jsdriskill/K6TTA-keyer/hardware/README.md

# K6TTA keyer hardware v0.1

Two KiCad 10 projects. Both boards are routed with GND pours on both layers and pass DRC
(only cosmetic silkscreen and library-version warnings remain).

* `k6tta-main/` main board, 64 x 56 mm: RP2040-Zero on sockets (USB-C to the rear), rig jack at the rear facing back,
  paddle jack front-right, headphone jack left with the thumbwheel in front of it, 2x8 right-angle socket on the front edge.
* `k6tta-front/` front board, 76 x 54 mm: 0.96in SSD1306 OLED (on a 1x4 socket), EC11 encoder, three 12 mm message buttons,
  2x8 straight header soldered on the BACK so it plugs into the main board's right-angle socket.

Pin assignments come from `config.h` (GP2 dit, GP3 dah, GP4 TX key, GP5 sidetone, GP6-8 encoder,
GP9-11 message buttons, GP12/13 I2C).

The KiCad files are the source of truth. The scripts in `generator/` produced the first unrouted draft and the
netlist/BOM CSVs; part positions in them no longer match the routed boards.

## Checked

* **RP2040-Zero pinout** (`K6TTA:RP2040-Zero_Socketed`): pad 1 = 5V top-left with USB-C up, GP0 top-right,
  GP9..GP13 on the short row opposite the USB (GP13 at the left). Confirmed against the clone in use.
* **Thumbwheel RV1** (Alps RK10J11E0034, `K6TTA:Alps_RK10J_Thumbwheel_5pin`): footprint checked against the Alps
  PC board drawing. It is a single pot: pads 1, 3, 5 = datasheet pins 1 (end), 2 (wiper), 3 (end); pads 2 and 4
  are dummy terminals. Wired as a rheostat: VOL_IN to pad 1, wiper (pad 3) tied to pad 5 and the headphones.

## Still to check

* **Board-to-board header**: main J5 odd pins (rear row of the right-angle socket, upper opening) carry the signals;
  front J1 even pins (upper row) mate with them. Check the height of the socket openings against where the front board sits.
* **OLED module**: pin order GND VCC SCL SDA; it is held only by its socket, so support it with standoffs or the panel.
* **LCSC numbers**: all JLCPCB-placed parts are chosen from the Basic library (the "JLC class" column says which were
  confirmed); re-check stock when you order.

R8 (speaker series resistor) is a 1/2 W axial part you solder, so you can change the speaker level.
