jsdriskill/K6TTA-keyer/hardware/k6tta-main/k6tta-main-netlist.csv

Net | Pins
+3V3 | C8.1 J5.4 R1.2 R2.2 U1.3
+5V | C5.1 C6.1 C7.1 R8.1 U1.1
DAH | C2.1 J1.R R2.1 U1.20
DIT | C1.1 J1.T R1.1 U1.21
ENC_A | J5.15 U1.17
ENC_B | J5.13 U1.16
ENC_SW | J5.11 U1.15
GATE | Q1.1 R6.2 R7.1
GND | C1.2 C2.2 C3.2 C5.2 C6.2 C7.2 C8.2 J1.S J3.S J5.2 J5.6 J5.8 J5.10 J5.12 J5.14 J5.16 Q1.2 R7.2 U1.2 U2.2
HP | J3.R J3.T RV1.3 RV1.5
HP_SW | J3.TN R6.1
LED_A | R3.2 U2.1
MSG1 | J5.9 U1.14
MSG2 | J5.7 U1.13
MSG3 | J5.5 U1.12
OPTO_B | R4.1 U2.6
RIG_COM | C3.1 C4.2 J2.S R4.2 U2.4
RIG_KEY | C4.1 J2.T U2.5
SCL | J5.1 U1.10
SDA | J5.3 U1.11
SIDETONE | R5.1 U1.18
SPK_N | D1.2 J4.2 Q1.3
SPK_P | D1.1 J4.1 R8.2
TX_KEY | R3.1 U1.19
VOL_IN | R5.2 RV1.1
