jsdriskill/K6TTA-keyer/hardware/k6tta-front/k6tta-front-netlist.csv

Net | Pins
+3V3 | J1.3 J2.2
ENC_A | J1.16 SW1.A
ENC_B | J1.14 SW1.B
ENC_SW | J1.12 SW1.S1
GND | J1.1 J1.5 J1.7 J1.9 J1.11 J1.13 J1.15 J2.1 SW1.C SW1.S2 SW2.2 SW3.2 SW4.2
MSG1 | J1.10 SW2.1
MSG2 | J1.8 SW3.1
MSG3 | J1.6 SW4.1
SCL | J1.2 J2.3
SDA | J1.4 J2.4
