jsdriskill/K6TTA-keyer/hardware/previews/k6tta-front-preview.png

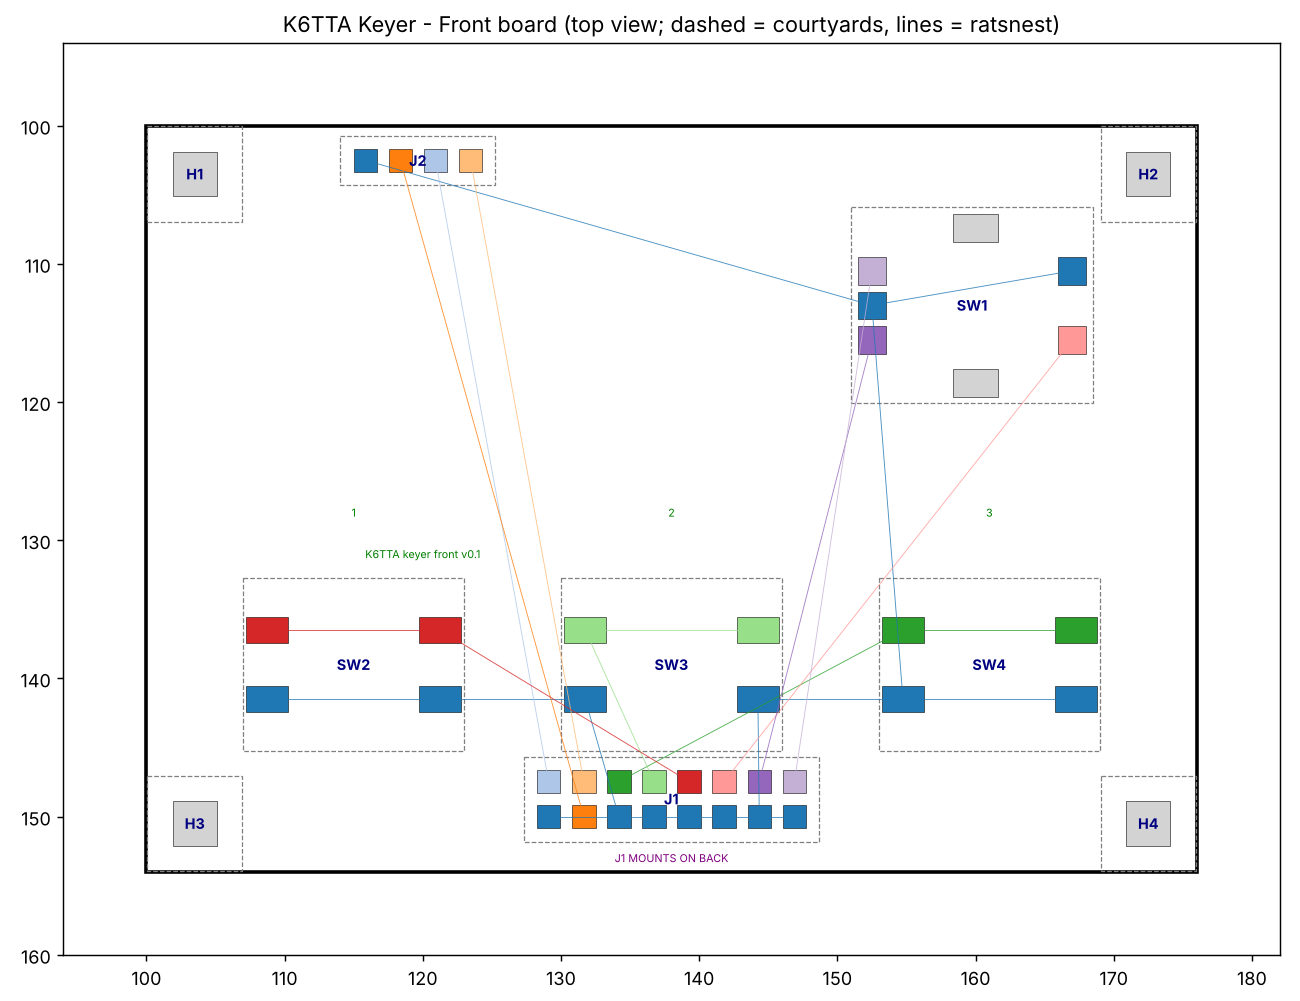
hardware/previews/k6tta-front-preview.png
