jsdriskill/K6TTA-keyer/hardware/previews/k6tta-main-preview.png

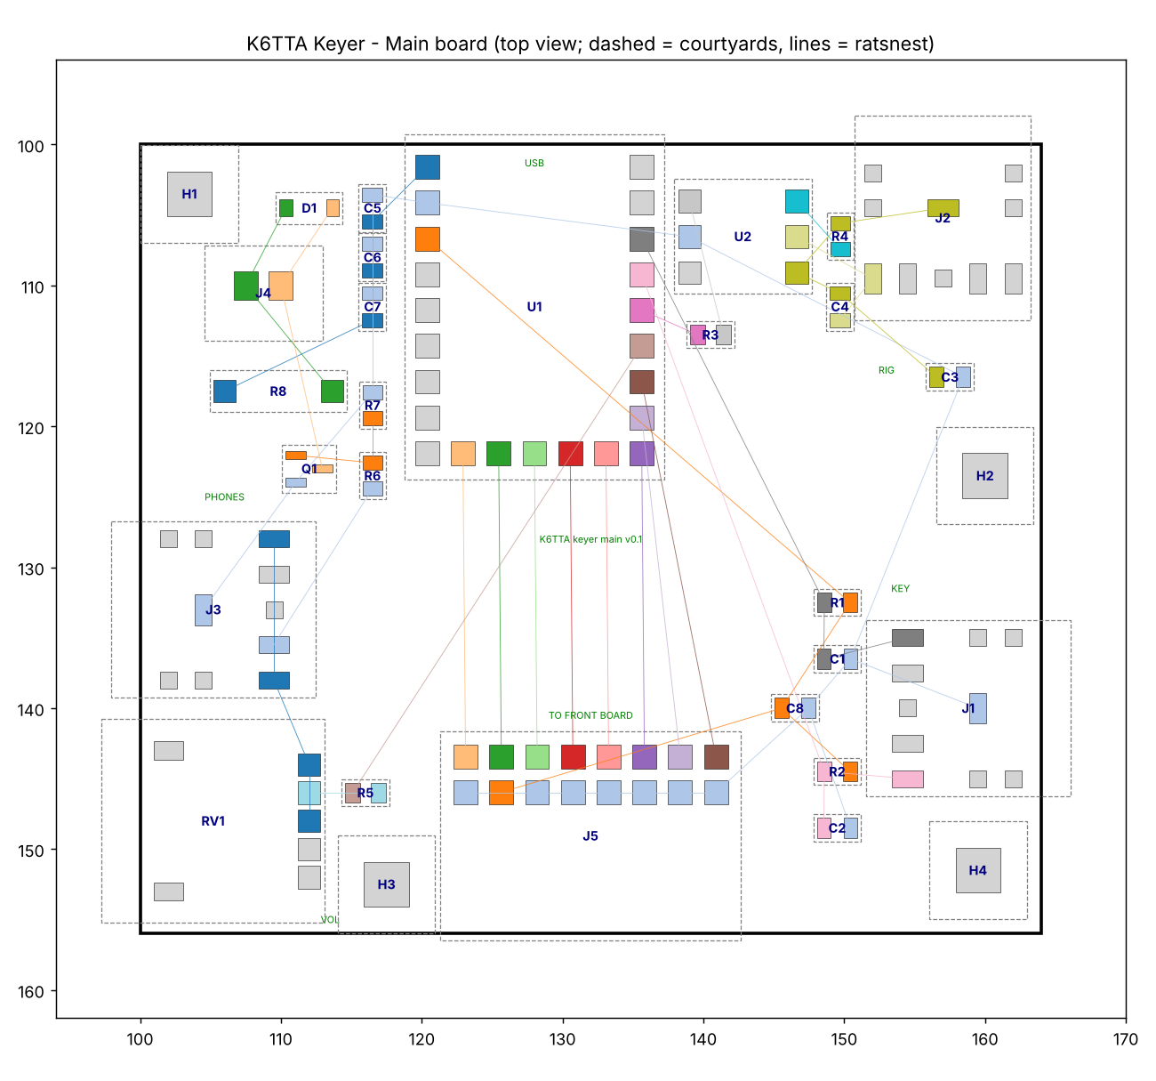
hardware/previews/k6tta-main-preview.png
