jsdriskill/K6TTA-keyer/hardware/k6tta-main/k6tta-main.kicad_pcb

## KiCad design hardware/k6tta-main/k6tta-main.kicad_pcb (2026-11-14)

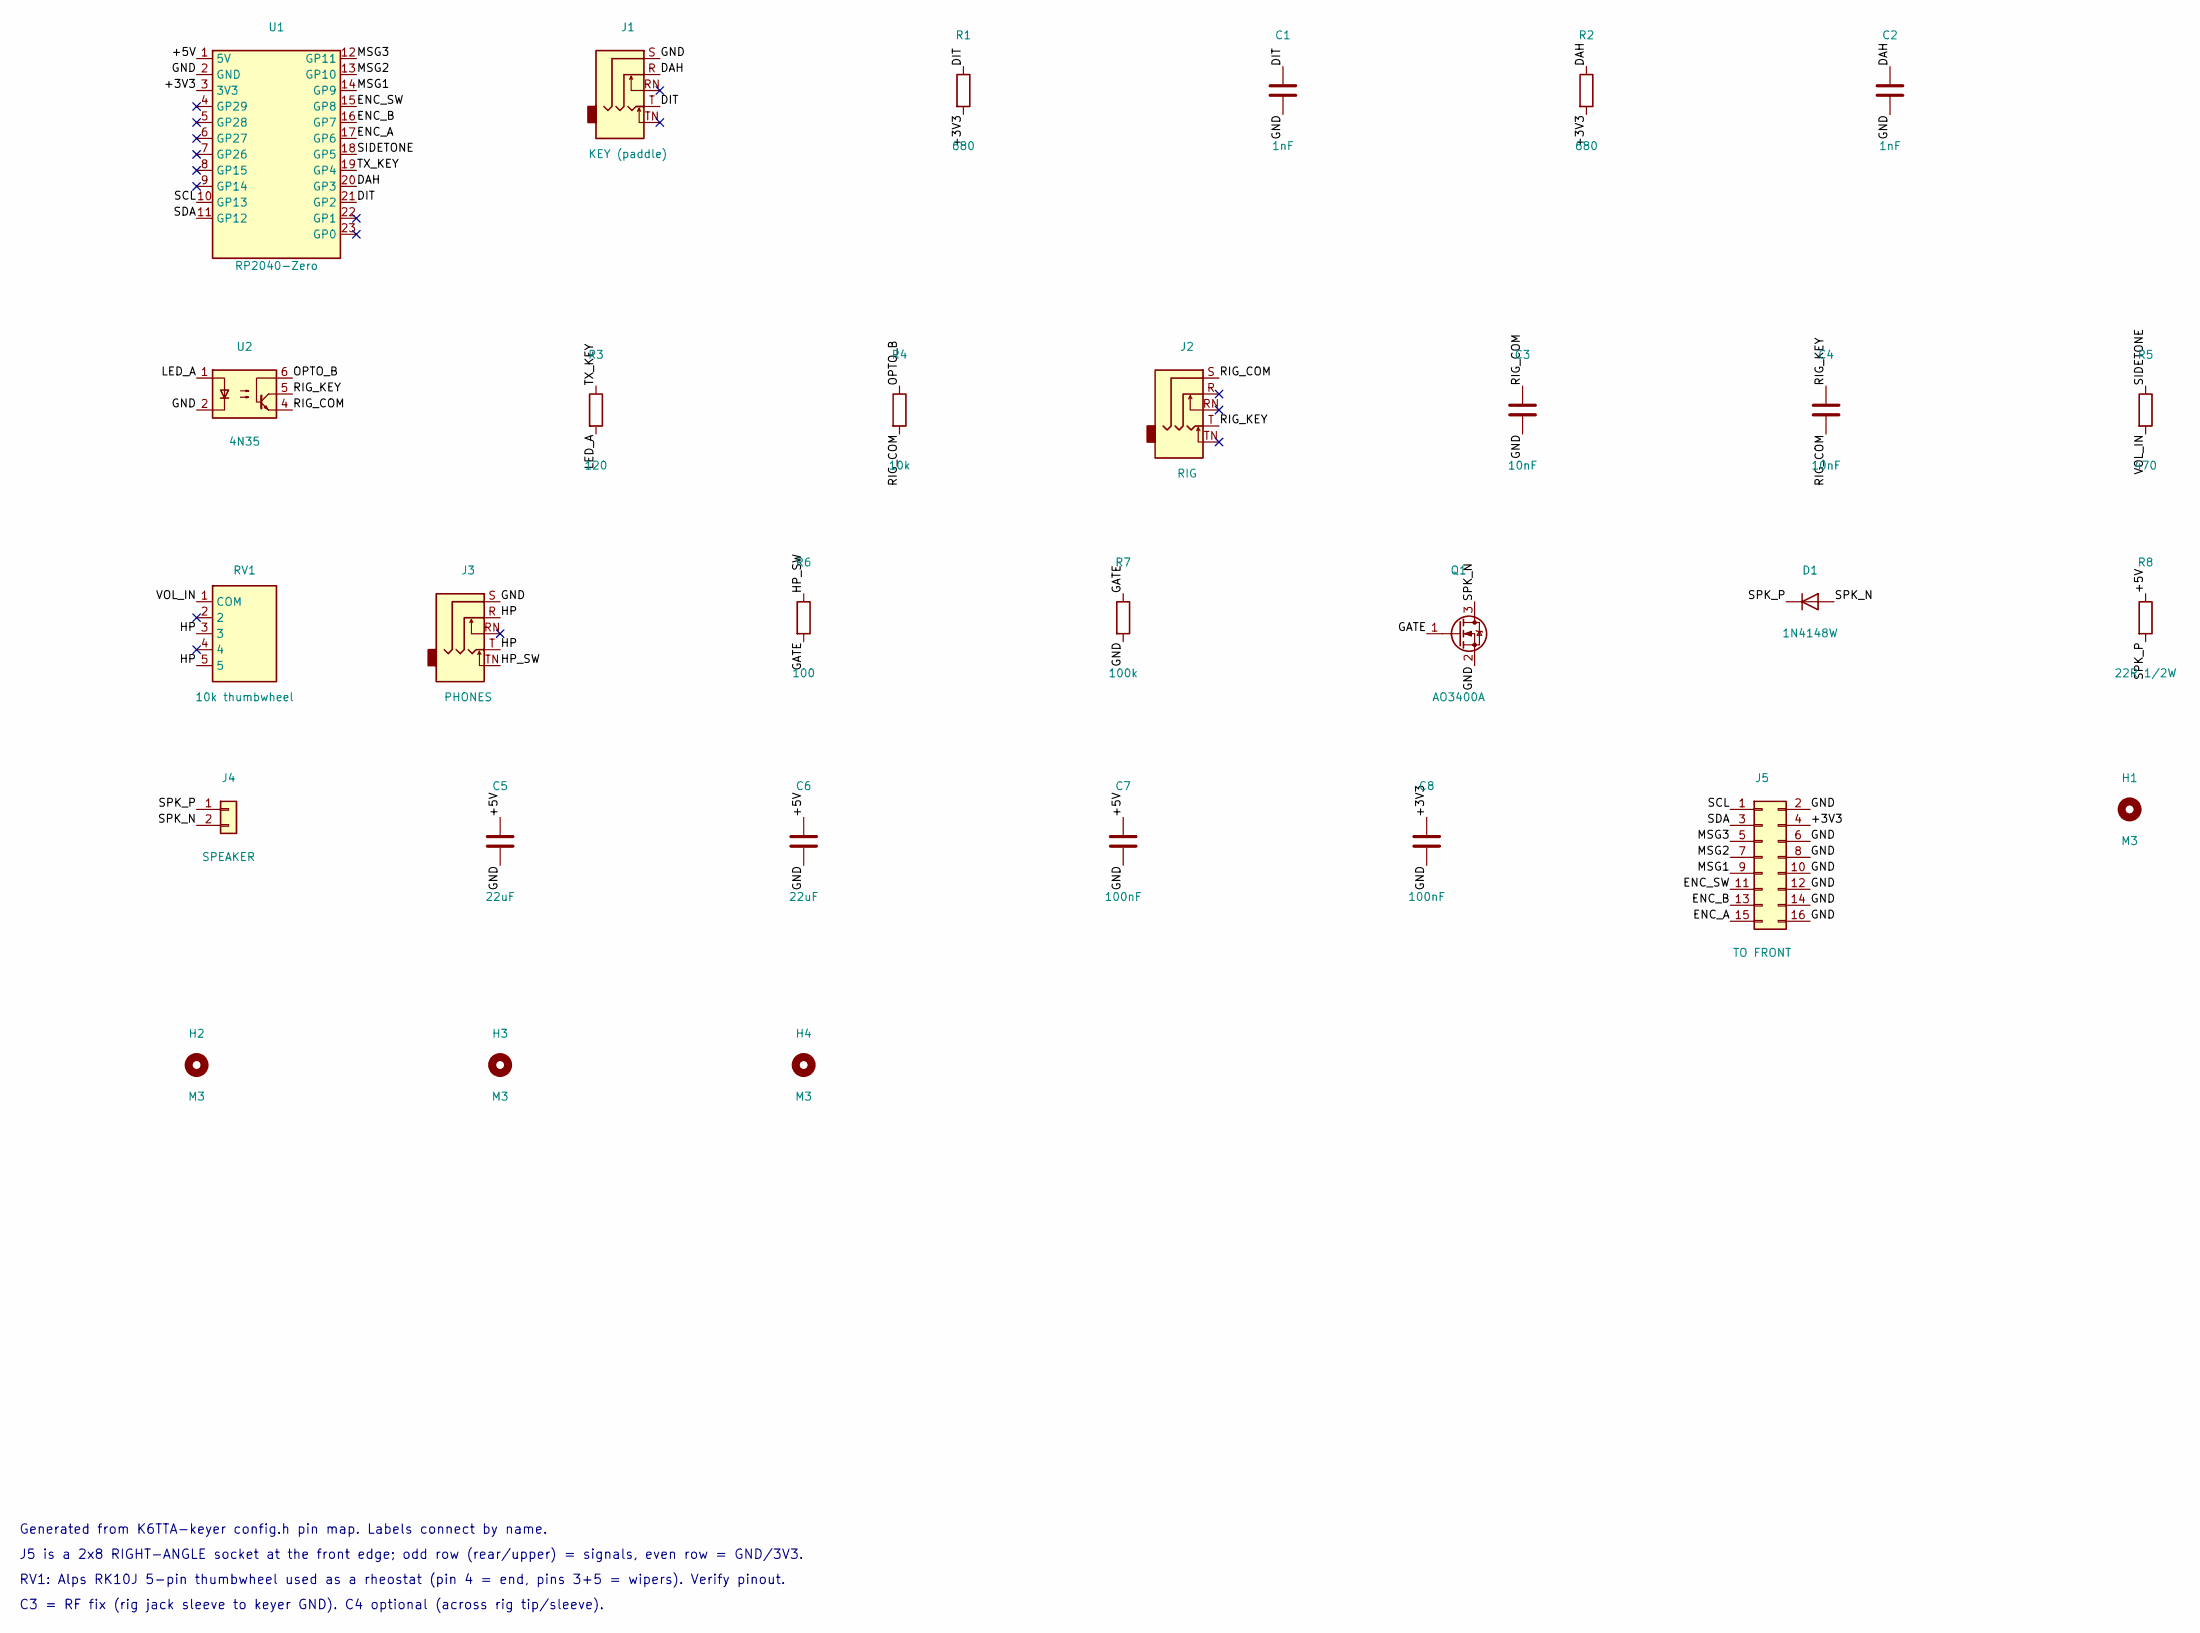
[picture p3: schematic k6tta-main.kicad_sch, K6TTA Keyer - Main board]

Parts:
C1, C2: 1nF; C_0805_2012Metric; LCSC C46653
C3, C4: 10nF; C_0805_2012Metric; LCSC C1710
C5, C6: 22uF; C_0805_2012Metric; LCSC C45783
C7, C8: 100nF; C_0805_2012Metric; LCSC C49678
D1: 1N4148W; D_SOD-123; LCSC C81598
H1, H2, H3, H4: M3; MountingHole_3.2mm_M3
J1: KEY (paddle); Jack_3.5mm_CUI_SJ1-3525N_Horizontal; MPN/Notes Same Sky SJ1-3525N
J2: RIG; Jack_3.5mm_CUI_SJ1-3525N_Horizontal; MPN/Notes Same Sky SJ1-3525N
J3: PHONES; Jack_3.5mm_CUI_SJ1-3525N_Horizontal; MPN/Notes Same Sky SJ1-3525N
J4: SPEAKER; JST_XH_B2B-XH-A_1x02_P2.50mm_Vertical; MPN/Notes JST B2B-XH-A
J5: TO FRONT; PinSocket_2x08_P2.54mm_Horizontal; MPN/Notes 2x8 female socket, right angle, 2.54mm
Q1: AO3400A; SOT-23; LCSC C20917
R1, R2: 680; R_0805_2012Metric; LCSC C17798
R3: 120; R_0805_2012Metric; LCSC C17437
R4: 10k; R_0805_2012Metric; LCSC C17414
R5: 470; R_0805_2012Metric; LCSC C17710
R6: 100; R_0805_2012Metric; LCSC C17408
R7: 100k; R_0805_2012Metric; LCSC C149504
R8: 22R 1/2W; R_Axial_DIN0207_L6.3mm_D2.5mm_P7.62mm_Horizontal; MPN/Notes 22 ohm 0.5W axial (change value to set 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
RV1: 10k thumbwheel; Alps_RK10J_Thumbwheel_5pin; MPN/Notes Alps RK10J11E0034; LCSC C470643
U1: RP2040-Zero; RP2040-Zero_Socketed
U2: 4N35; DIP-6_W7.62mm; MPN/Notes 4N35 DIP-6 (socket optional)

Connections:
/+3V3: C8.1, J5.4, R1.2, R2.2, U1.3 (3V3)
/+5V: C5.1, C6.1, C7.1, R8.1, U1.1 (5V)
/DAH: C2.1, J1.R, R2.1, U1.20 (GP3)
/DIT: C1.1, J1.T, R1.1, U1.21 (GP2)
/ENC_A: J5.15, U1.17 (GP6)
/ENC_B: J5.13, U1.16 (GP7)
/ENC_SW: J5.11, U1.15 (GP8)
/GATE: Q1.1 (G), R6.2, R7.1
/GND: C1.2, C2.2, C3.2, C5.2, C6.2, C7.2, C8.2, J1.S, J3.S, J5.2, J5.6, J5.8, J5.10, J5.12, J5.14, J5.16, Q1.2 (S), R7.2, U1.2 (GND), U2.2
/HP: J3.R, J3.T, RV1.3, RV1.5
/HP_SW: J3.TN, R6.1
/LED_A: R3.2, U2.1
/MSG1: J5.9, U1.14 (GP9)
/MSG2: J5.7, U1.13 (GP10)
/MSG3: J5.5, U1.12 (GP11)
/OPTO_B: R4.1, U2.6
/RIG_COM: C3.1, C4.2, J2.S, R4.2, U2.4
/RIG_KEY: C4.1, J2.T, U2.5
/SCL: J5.1, U1.10 (GP13)
/SDA: J5.3, U1.11 (GP12)
/SIDETONE: R5.1, U1.18 (GP5)
/SPK_N: D1.2 (A), J4.2, Q1.3 (D)
/SPK_P: D1.1 (K), J4.1, R8.2
/TX_KEY: R3.1, U1.19 (GP4)
/VOL_IN: R5.2, RV1.1 (COM)

Notes on the sheet:
J5 is a 2x8 RIGHT-ANGLE socket at the front edge; odd row (rear/upper) = signals, even row = GND/3V3.
RV1: Alps RK10J 5-pin thumbwheel used as a rheostat (pin 4 = end, pins 3+5 = wipers). Verify pinout.
Generated from K6TTA-keyer config.h pin map. Labels connect by name.
C3 = RF fix (rig jack sleeve to keyer GND). C4 optional (across rig tip/sleeve).

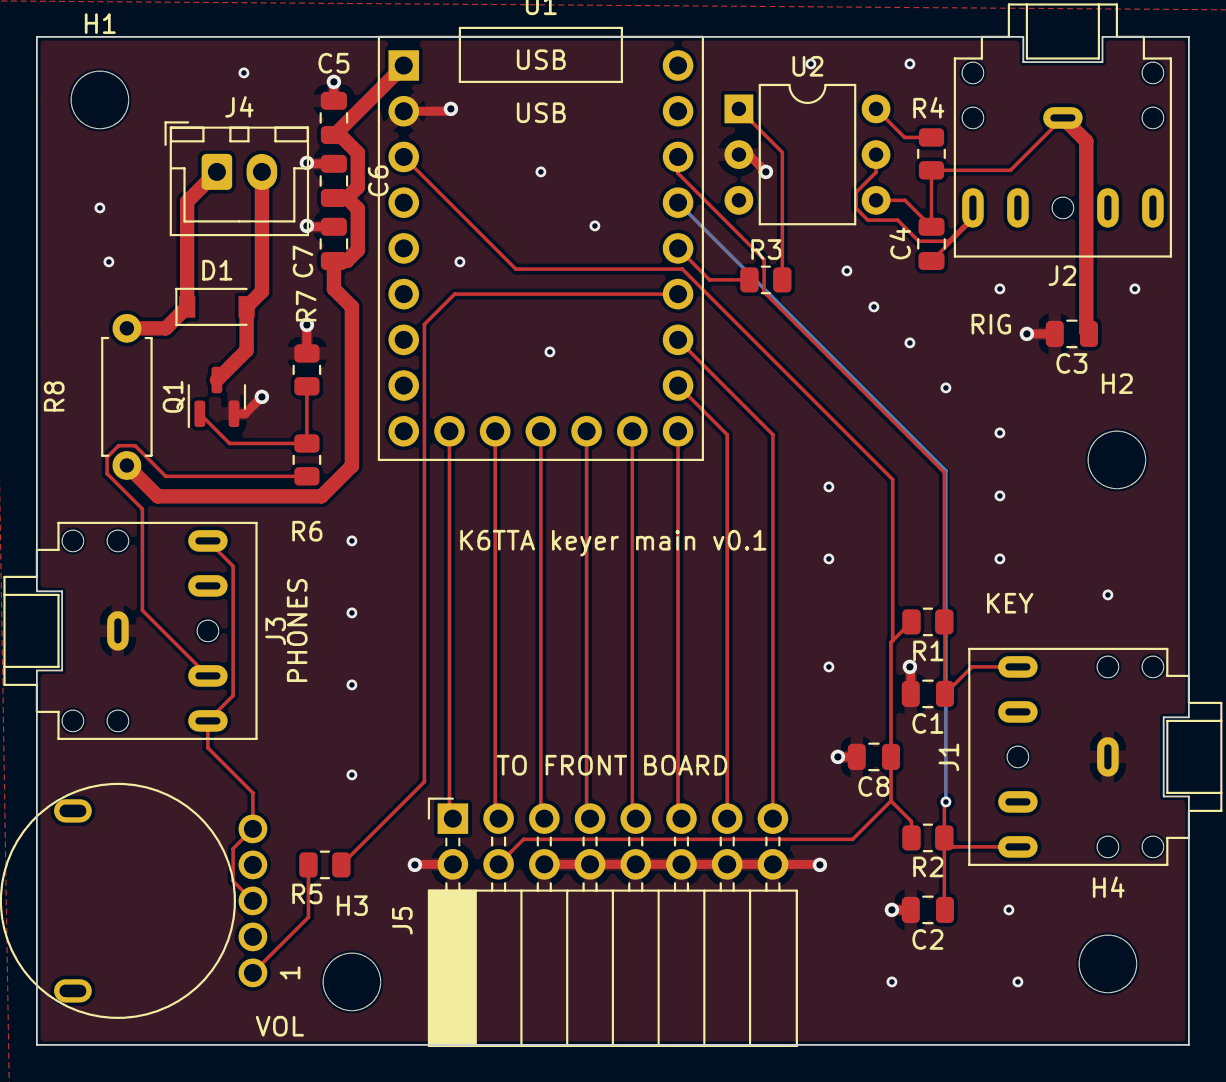
[picture p4: board k6tta-main.kicad_pcb from above]

Board: 2 copper layers, 64.0 x 56.0 mm, 30 parts (0 on the bottom side), 25 nets.
