jsdriskill/K6TTA-keyer/hardware/k6tta-front/k6tta-front.kicad_pcb

## KiCad design hardware/k6tta-front/k6tta-front.kicad_pcb (2026-11-13)

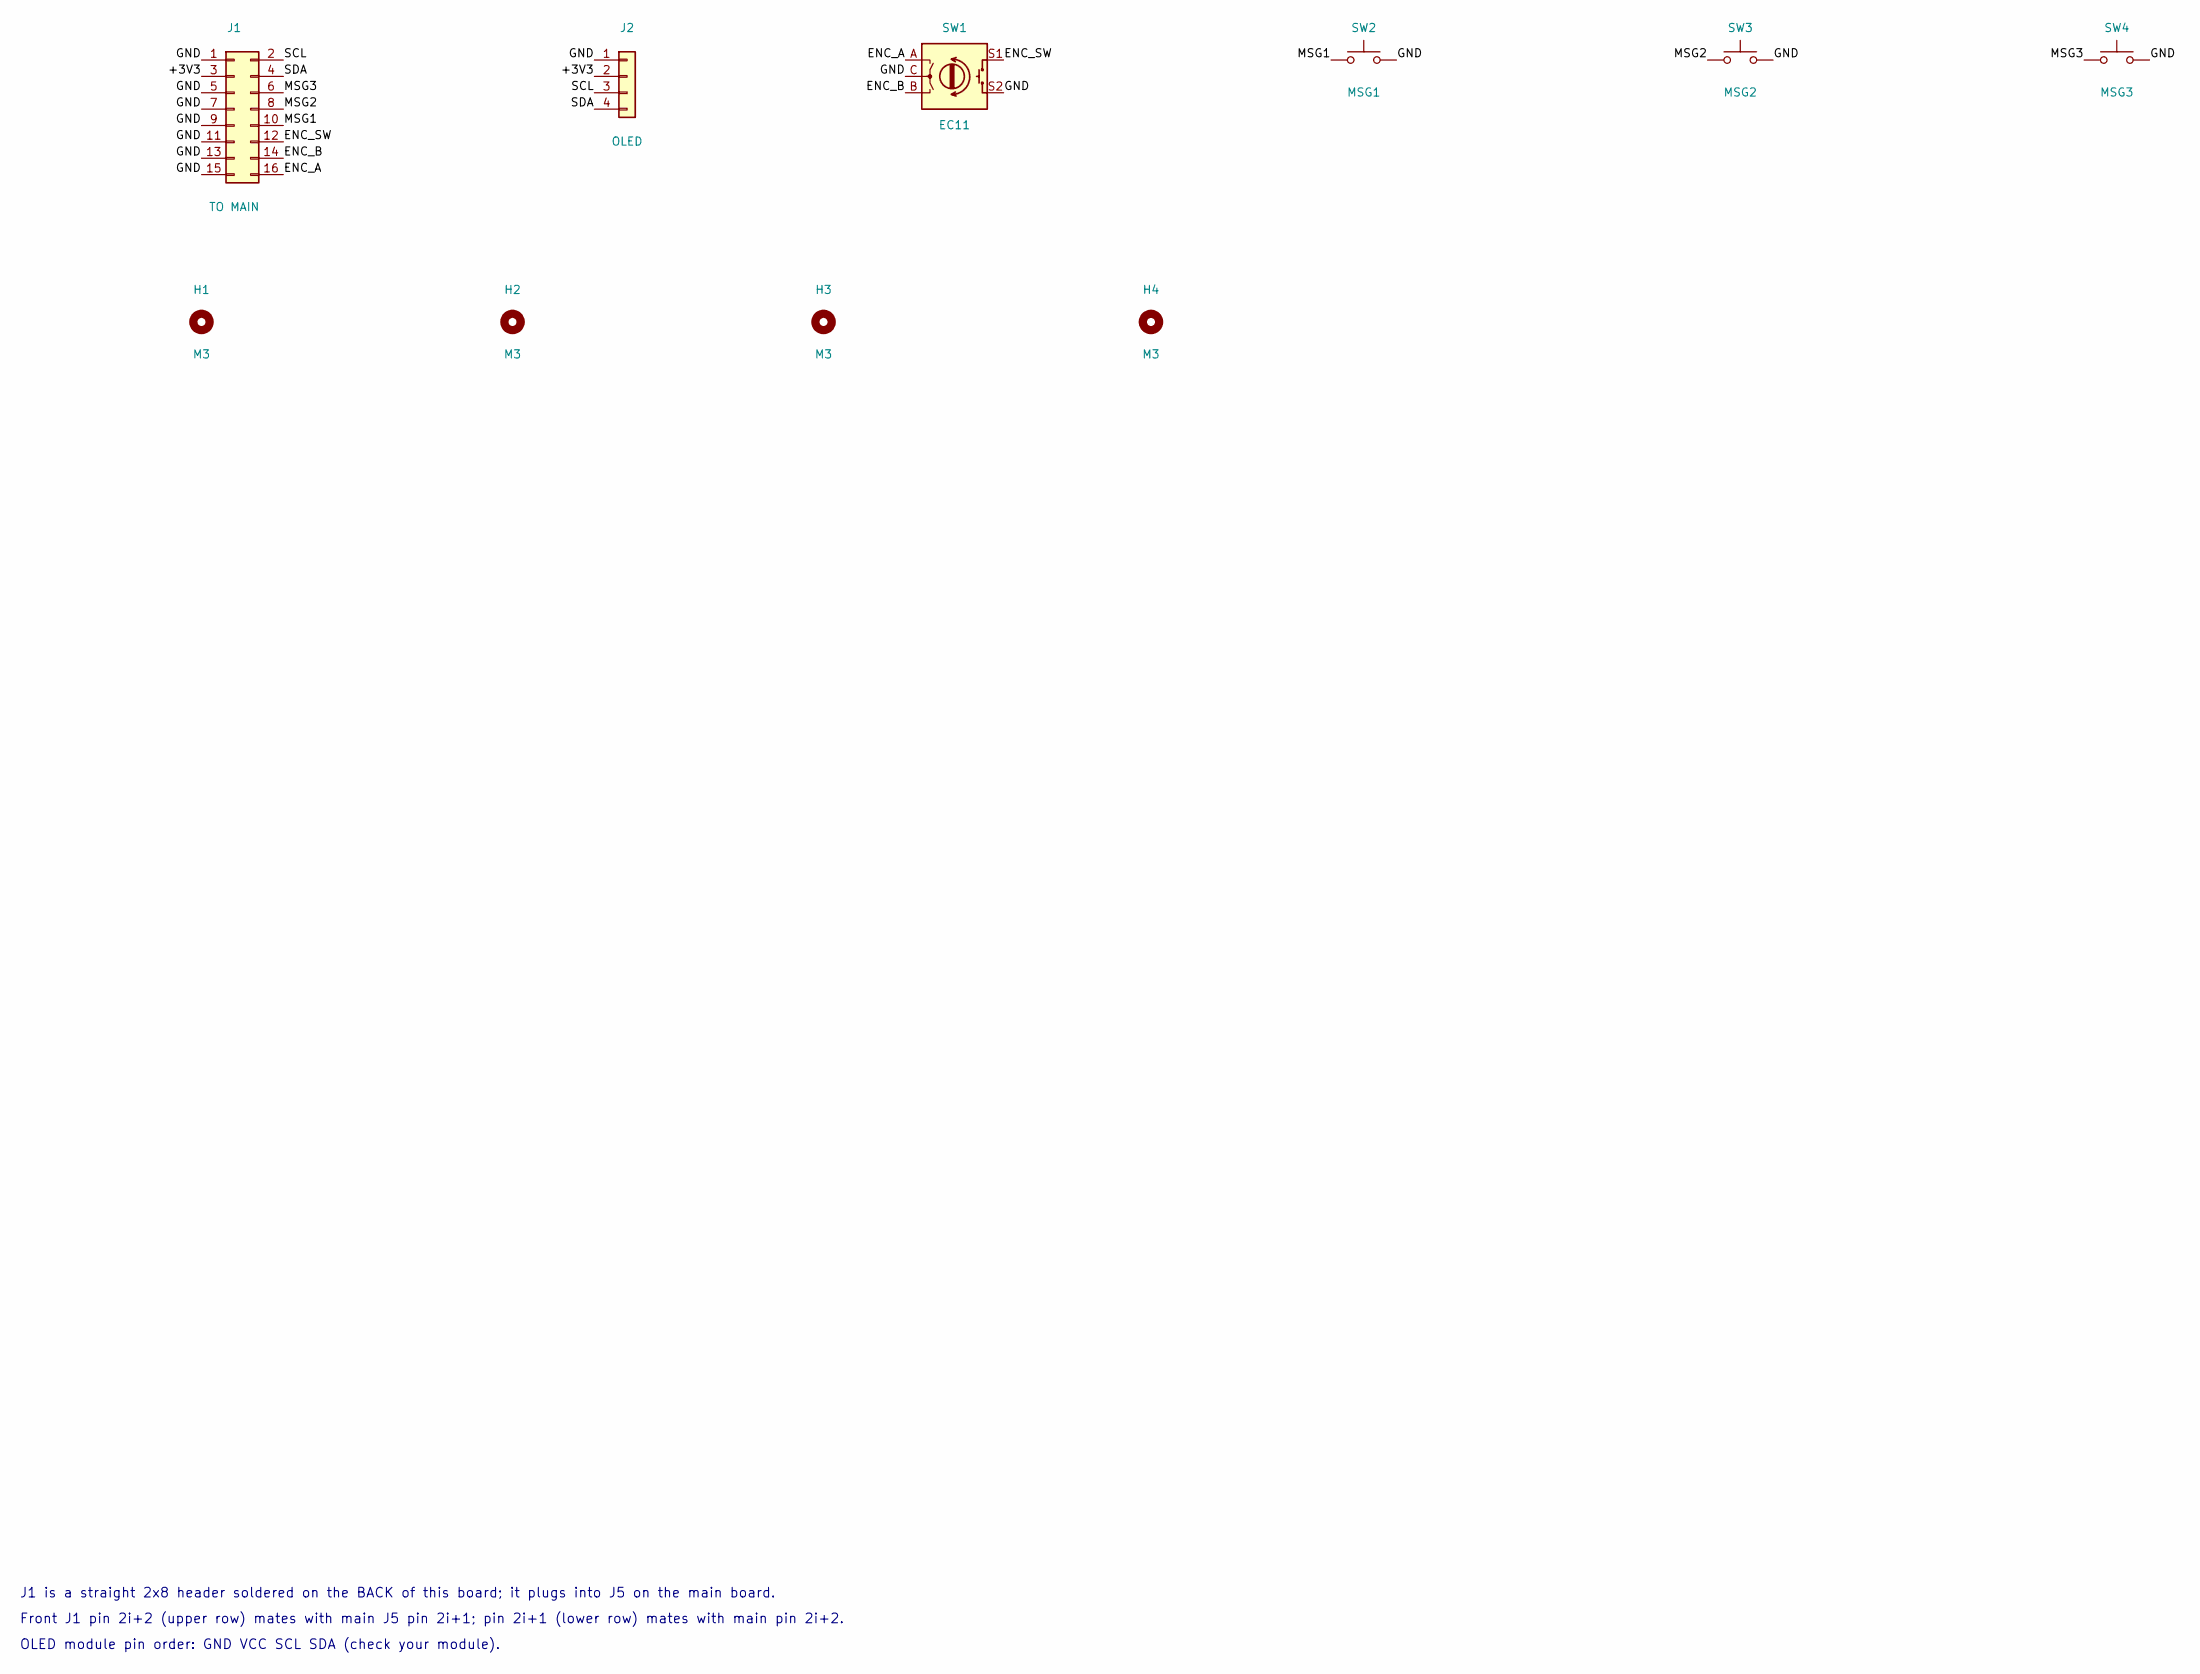
[picture p5: schematic k6tta-front.kicad_sch, K6TTA Keyer - Front board]

Parts:
H1, H2, H3, H4: M3; MountingHole_3.2mm_M3
J1: TO MAIN; PinHeader_2x08_P2.54mm_Vertical; MPN/Notes 2x8 male header 2.54mm, straight; MOUNT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
J2: OLED; PinSocket_1x04_P2.54mm_Vertical; MPN/Notes 1x4 female header for 0.96in SSD1306 I2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
SW1: EC11; RotaryEncoder_Alps_EC11E-Switch_Vertical_H20mm; MPN/Notes EC11 with push switch
SW2: MSG1; SW_PUSH-12mm; MPN/Notes Omron B3F-4055 + B32-2000 series cap; LCSC C84931
SW3: MSG2; SW_PUSH-12mm; MPN/Notes Omron B3F-4055 + B32-2000 series cap; LCSC C84931
SW4: MSG3; SW_PUSH-12mm; MPN/Notes Omron B3F-4055 + B32-2000 series cap; LCSC C84931

Connections:
/+3V3: J1.3, J2.2
/ENC_A: J1.16, SW1.A
/ENC_B: J1.14, SW1.B
/ENC_SW: J1.12, SW1.S1
/GND: J1.1, J1.5, J1.7, J1.9, J1.11, J1.13, J1.15, J2.1, SW1.C, SW1.S2, SW2.2, SW3.2, SW4.2
/MSG1: J1.10, SW2.1
/MSG2: J1.8, SW3.1
/MSG3: J1.6, SW4.1
/SCL: J1.2, J2.3
/SDA: J1.4, J2.4

Notes on the sheet:
OLED module pin order: GND VCC SCL SDA (check your module).
Front J1 pin 2i+2 (upper row) mates with main J5 pin 2i+1; pin 2i+1 (lower row) mates with main pin 2i+2.
J1 is a straight 2x8 header soldered on the BACK of this board; it plugs into J5 on the main board.

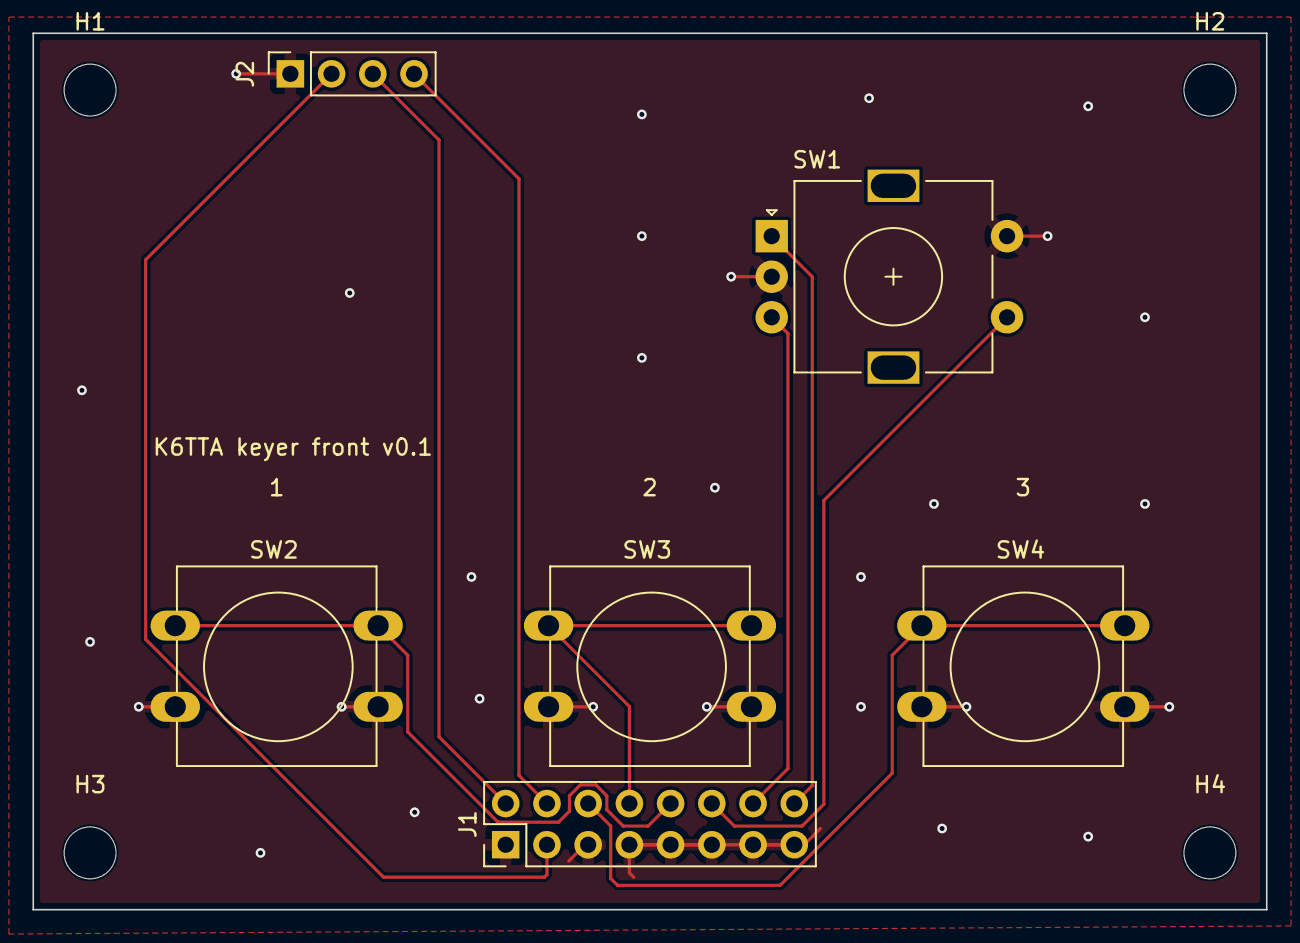
[picture p6: board k6tta-front.kicad_pcb from above]

Board: 2 copper layers, 76.0 x 54.0 mm, 10 parts (0 on the bottom side), 10 nets.
