jsdriskill/K6TTA-keyer/keyer.c

#include "keyer.h"
#include "textview.h"

#include "pico/stdlib.h"
#include "pico/util/queue.h"
#include "hardware/gpio.h"
#include "hardware/clocks.h"
#include "sidetone.h"
#include "usb_device.h"

typedef enum {
    STATE_IDLE,
    STATE_DIT,
    STATE_DASH,
    STATE_ELEMENT_SPACE,
    STATE_AUTOSPACE
} KeyerState;

static KeyerState current_state = STATE_IDLE;
static uint32_t state_timer = 0;
static bool dit_latched = false;
static bool dash_latched = false;
static bool last_was_dit = false;
static bool bug_dah_flag;               /* bug mode: dah key-down is in progress */
static bool first_element = true;

typedef struct { bool state, cand; uint32_t since; } Debounce;
static Debounce deb_dit, deb_dash;
static bool paddles_armed;              /* false from power-up until both paddles have been released */

/* ------------------------------------------------------------------------
 * Text sender (used by the WinKeyer serial port)
 *
 * Core 1 (WinKeyer parser) feeds characters through tx_q; this core turns them
 * into Morse. Sent characters, and characters decoded from the paddles, go back
 * to core 1 through echo_q. Paddle input always wins: touching a paddle drops
 * everything queued ("break-in").
 * ---------------------------------------------------------------------- */
#define TX_Q_DEPTH     160          /* host stops at the XOFF level, well below this */
#define TX_LOCAL_SIZE  128          /* the WinKeyer buffer size */
#define TX_CMD_CLEAR   0x100u
#define ECHO_Q_DEPTH   32

typedef struct {
    char    ch;
    uint8_t len;
    uint8_t bits;       /* MSB first of the low 'len' bits; 1 = dash */
} MorseEntry;

static const MorseEntry morse_table[] = {
    {'A',2,0x01},{'B',4,0x08},{'C',4,0x0A},{'D',3,0x04},{'E',1,0x00},{'F',4,0x02},
    {'G',3,0x06},{'H',4,0x00},{'I',2,0x00},{'J',4,0x07},{'K',3,0x05},{'L',4,0x04},
    {'M',2,0x03},{'N',2,0x02},{'O',3,0x07},{'P',4,0x06},{'Q',4,0x0D},{'R',3,0x02},
    {'S',3,0x00},{'T',1,0x01},{'U',3,0x01},{'V',4,0x01},{'W',3,0x03},{'X',4,0x09},
    {'Y',4,0x0B},{'Z',4,0x0C},
    {'1',5,0x0F},{'2',5,0x07},{'3',5,0x03},{'4',5,0x01},{'5',5,0x00},
    {'6',5,0x10},{'7',5,0x18},{'8',5,0x1C},{'9',5,0x1E},{'0',5,0x1F},
    {'.',6,0x15},{',',6,0x33},{'?',6,0x0C},{'/',5,0x12},{'=',5,0x11},{'+',5,0x0A},
    {'-',6,0x21},{'(',5,0x16},{')',6,0x2D},{'\'',6,0x1E},{'!',6,0x2B},{'&',5,0x08},
    {':',6,0x38},{';',6,0x2A},{'"',6,0x12},{'$',7,0x09},{'_',6,0x0D},{'@',6,0x1A},
};
/* Prosigns recognised when decoding paddle input only. */
#define PROSIGN_SK_LEN   6
#define PROSIGN_SK_BITS  0x05       /* ...-.- */

#define MORSE_COUNT (sizeof(morse_table) / sizeof(morse_table[0]))

/* Show a character on the main screen. The prosigns that the table holds as
 * punctuation (BT as '=', AR as '+') are shown in angle brackets. */
static void show_text(const char *str) {
    while (*str) {
        textview_put(*str++);
    }
}

static void show_char(char c) {
    if (c == '=') {
        show_text("<BT>");
    } else if (c == '+') {
        show_text("<AR>");
    } else {
        textview_put(c);
    }
}

static const MorseEntry *morse_lookup(char c) {
    if (c >= 'a' && c <= 'z') {
        c = (char)(c - 'a' + 'A');
    }
    for (unsigned i = 0; i < MORSE_COUNT; i++) {
        if (morse_table[i].ch == c) {
            return &morse_table[i];
        }
    }
    return NULL;
}

typedef enum { TX_IDLE, TX_KEYDOWN, TX_GAP } TxState;

static queue_t tx_q;
static queue_t echo_q;
static uint8_t tx_buf[TX_LOCAL_SIZE];       /* characters waiting, core 0 only */
static uint8_t tx_head, tx_tail;
static volatile uint8_t tx_count;           /* mirrored for core 1 */
static TxState tx_state = TX_IDLE;
static const MorseEntry *tx_cur;
static uint8_t tx_idx;                      /* next element of tx_cur */
static uint32_t tx_timer;
static volatile uint8_t tx_put_count;       /* chars queued: written by core 1 only */
static volatile uint8_t tx_pull_count;      /* chars taken from the queue: written by core 0 only */
static volatile bool breakin_flag;
static volatile bool echo_serial, echo_paddle;

/* paddle decoder for paddle echo */
static uint8_t pe_len, pe_bits;
static bool pe_over;                    /* the character being sent had too many elements */
static bool pe_space_pending;
static uint32_t pe_last_off;
static uint32_t tick_now;

static void echo_put(char c) {
    uint8_t v = (uint8_t)c;
    queue_try_add(&echo_q, &v);
}

static void tx_local_flush(void) {
    tx_head = tx_tail = 0;
    tx_count = 0;
}

static void tx_pull(void) {
    uint16_t item;
    while (queue_try_remove(&tx_q, &item)) {
        if (item == TX_CMD_CLEAR) {
            tx_local_flush();
        } else {
            tx_pull_count++;
            if (tx_count >= TX_LOCAL_SIZE) {
                continue;
            }
            tx_buf[tx_head] = (uint8_t)item;
            tx_head = (uint8_t)((tx_head + 1) % TX_LOCAL_SIZE);
            tx_count++;
        }
    }
}

bool keyer_tx_put(uint8_t c) {
    uint16_t item = c;
    breakin_flag = false;
    if (!queue_try_add(&tx_q, &item)) {
        return false;
    }
    tx_put_count++;
    return true;
}

void keyer_tx_clear(void) {
    uint16_t item = TX_CMD_CLEAR;
    breakin_flag = false;
    queue_try_add(&tx_q, &item);
}

uint8_t keyer_tx_pending(void) {
    unsigned n = (uint8_t)(tx_put_count - tx_pull_count) + tx_count;
    return n > 255 ? 255 : (uint8_t)n;
}

bool keyer_tx_busy(void) {
    return tx_state != TX_IDLE || keyer_tx_pending() > 0;
}

bool keyer_breakin(void) {
    return breakin_flag;
}

int keyer_echo_get(void) {
    uint8_t v;
    return queue_try_remove(&echo_q, &v) ? (int)v : -1;
}

void keyer_set_echo(bool serial, bool paddle) {
    echo_serial = serial;
    echo_paddle = paddle;
}

static uint32_t dit_unit(void) {
    uint8_t wpm = sys_config.wpm;
    if (wpm < 5) {
        wpm = 5;
    }
    return 1200 / wpm;
}

static uint32_t weighted_dit(void) {
    uint32_t unit = dit_unit();
    uint8_t w = sys_config.weighting;
    if (w < 10) {
        w = 10;
    }
    if (w > 90) {
        w = 90;
    }
    return (unit * w) / 50;
}

static uint32_t dash_len(void) {
    uint32_t unit = dit_unit();
    uint8_t ratio = sys_config.dash_ratio;
    if (ratio < 20) {
        ratio = 20;
    }
    if (ratio > 40) {
        ratio = 40;
    }
    return (unit * ratio) / 10;
}

static void key_on(void) {
    gpio_put(PIN_TX_KEY, 1);
    keyer_set_sidetone(true);
    usb_key_event(true);    /* mirrored sidetone (USB audio) + MIDI note on */
}

static void key_off(void) {
    pe_last_off = tick_now;
    gpio_put(PIN_TX_KEY, 0);
    keyer_set_sidetone(false);
    usb_key_event(false);
}

void keyer_init(void) {
    queue_init(&tx_q, sizeof(uint16_t), TX_Q_DEPTH);
    queue_init(&echo_q, sizeof(uint8_t), ECHO_Q_DEPTH);

    gpio_init(PIN_PADDLE_DIT);
    gpio_set_dir(PIN_PADDLE_DIT, GPIO_IN);
    gpio_disable_pulls(PIN_PADDLE_DIT);     /* external pull-up resistors; also turns off the pad's reset-state pull-down */

    gpio_init(PIN_PADDLE_DASH);
    gpio_set_dir(PIN_PADDLE_DASH, GPIO_IN);
    gpio_disable_pulls(PIN_PADDLE_DASH);

    gpio_init(PIN_TX_KEY);
    gpio_set_dir(PIN_TX_KEY, GPIO_OUT);
    gpio_put(PIN_TX_KEY, 0);

    /* The external pull-up resistors need time to charge whatever capacitance is
     * on the paddle lines (filter capacitors in the jack, a long cable). Read too soon
     * and both paddles look pressed, which sends a dit and a dah: an "A" at
     * power-up. Wait (at most 50 ms) for both lines to go high. A paddle really
     * held down stays low and is dealt with by paddles_armed in keyer_tick(). */
    for (int i = 0; i < 500 && (!gpio_get(PIN_PADDLE_DIT) || !gpio_get(PIN_PADDLE_DASH)); i++) {
        sleep_us(100);
    }
    deb_dit.state = deb_dit.cand = !gpio_get(PIN_PADDLE_DIT);       /* start from what is really there */
    deb_dash.state = deb_dash.cand = !gpio_get(PIN_PADDLE_DASH);
    paddles_armed = false;

    sidetone_init();
}

bool keyer_is_busy(void) {
    return current_state != STATE_IDLE || bug_dah_flag;
}

static void pe_record(bool dash) {
    pe_space_pending = false;
    if (pe_len >= 7) {
        pe_over = true;             /* too long to be a character: shown as '*' when it ends */
        return;
    }
    pe_bits = (uint8_t)((pe_bits << 1) | (dash ? 1 : 0));
    pe_len++;
}

/* ---- paddle element generation, modelled on the K3NG keyer ----
 *
 * K3NG keeps one memory flag per paddle ("buffer"). While it sends an element
 * (and the gap after it) it samples only the OPPOSITE paddle's level; the
 * paddle that started the element is not looked at until the element and gap
 * are over, when both paddles are sampled by level. The next element is the
 * opposite one if it is remembered, else a repeat of the same one. This
 * port keeps those rules but runs them from keyer_tick() instead of blocking. */
enum { SENT_NONE, SENT_DIT, SENT_DAH };
static uint8_t being_sent = SENT_NONE;
static bool iambic_flag;                /* A mode: both paddles were closed together */

/* Lengths in ms, as K3NG: element = n * w/50 units, and the gap makes the
 * dit+gap pair 2 units and the dah+gap pair 4 - 3 + ratio*w units, so
 * weighting moves the key-down time without moving the character spacing. */
static uint8_t weight_clamped(void) {
    uint8_t w = sys_config.weighting;
    return w < 10 ? 10 : (w > 90 ? 90 : w);
}
static uint32_t dit_element_ms(void) { return weighted_dit(); }
static uint32_t dah_element_ms(void) {
    uint8_t ratio = sys_config.dash_ratio;
    if (ratio < 20) ratio = 20;
    if (ratio > 40) ratio = 40;
    return (dit_unit() * (uint32_t)ratio * weight_clamped()) / 500u;
}
static uint32_t dit_gap_ms(void) {
    int32_t g = ((int32_t)dit_unit() * (100 - weight_clamped())) / 50;
    return g > 0 ? (uint32_t)g : 0;
}
static uint32_t dah_gap_ms(void) {
    int32_t g = ((int32_t)dit_unit() * (200 - 3 * (int32_t)weight_clamped())) / 50;
    return g > 0 ? (uint32_t)g : 0;
}
/* extra space autospace inserts (K3NG default factor 2.0) so that the
 * character gap totals 3 units */
static uint32_t autospace_ms(void) { return 2 * dit_unit(); }

static void start_dit(uint32_t now) {
    pe_record(false);
    dit_latched = false;
    last_was_dit = true;
    being_sent = SENT_DIT;
    key_on();
    uint32_t len = dit_element_ms();
    if (first_element) {
        len += sys_config.first_extension;
        first_element = false;
    }
    state_timer = now + len;
    current_state = STATE_DIT;
}

static void start_dash(uint32_t now) {
    pe_record(true);
    dash_latched = false;
    last_was_dit = false;
    being_sent = SENT_DAH;
    key_on();
    uint32_t len = dah_element_ms();
    if (first_element) {
        len += sys_config.first_extension;
        first_element = false;
    }
    state_timer = now + len;
    current_state = STATE_DASH;
}

/* ---- sender state machine (core 0, 1 ms resolution like the paddle logic) ---- */
static void tx_abort(void) {
    if (tx_state == TX_KEYDOWN) {
        key_off();
    }
    tx_state = TX_IDLE;
    tx_cur = NULL;
    tx_local_flush();
}

static void tx_start_element(uint32_t now) {
    bool dash = (tx_cur->bits >> (tx_cur->len - 1 - tx_idx)) & 1;
    key_on();
    tx_timer = now + (dash ? dash_len() : weighted_dit());
    tx_idx++;
    tx_state = TX_KEYDOWN;
}

static void tx_start_next(uint32_t now) {
    while (tx_count > 0) {
        char c = (char)tx_buf[tx_tail];
        tx_tail = (uint8_t)((tx_tail + 1) % TX_LOCAL_SIZE);
        tx_count--;

        if (c == ' ') {
            /* the preceding character already ended with a 3 unit gap */
            tx_timer = now + 4 * dit_unit();
            tx_cur = NULL;
            tx_state = TX_GAP;
            textview_put(' ');
            if (echo_serial) {
                echo_put(' ');
            }
            return;
        }
        const MorseEntry *m = morse_lookup(c);
        if (m == NULL) {
            continue;               /* not sendable: skip silently */
        }
        tx_cur = m;
        tx_idx = 0;
        show_char(m->ch);
        if (echo_serial) {
            echo_put(m->ch);
        }
        tx_start_element(now);
        return;
    }
}

/* Stored messages are loaded straight into the local send buffer. Core 0 only,
 * so it does not touch the cross-core queue or its counters. */
void keyer_msg_abort(void) {
    tx_abort();
}

void keyer_msg_send(const char *text) {
    tx_abort();
    while (*text && tx_count < TX_LOCAL_SIZE) {
        tx_buf[tx_head] = (uint8_t)*text++;
        tx_head = (uint8_t)((tx_head + 1) % TX_LOCAL_SIZE);
        tx_count++;
    }
}

/* Called every tick while the sender is active. */
static void tx_run(uint32_t now) {
    switch (tx_state) {
        case TX_KEYDOWN:
            if (now >= tx_timer) {
                key_off();
                bool last = (tx_cur == NULL) || tx_idx >= tx_cur->len;
                tx_timer = now + (last ? 3 : 1) * dit_unit();   /* character gap / element gap */
                tx_state = TX_GAP;
            }
            break;
        case TX_GAP:
            if (now >= tx_timer) {
                if (tx_cur != NULL && tx_idx < tx_cur->len) {
                    tx_start_element(now);
                } else {
                    tx_cur = NULL;
                    tx_state = TX_IDLE;
                }
            }
            break;
        default:
            break;
    }
}

/* Decode what the paddles just sent and report it (paddle echo). */
static void paddle_echo_service(uint32_t now, bool paddle_down) {
    if (sys_config.mode == KEYER_MODE_STRAIGHT || sys_config.mode == KEYER_MODE_BUG) {
        pe_len = 0;
        pe_over = false;
        pe_space_pending = false;
        return;
    }
    if (current_state != STATE_IDLE || paddle_down) {
        return;
    }
    uint32_t idle = now - pe_last_off;
    if (pe_len > 0 && idle >= 2 * dit_unit()) {
        char decoded = '*';                 /* unknown or too long */
        if (!pe_over) {
            for (unsigned i = 0; i < MORSE_COUNT; i++) {
                if (morse_table[i].len == pe_len && morse_table[i].bits == pe_bits) {
                    decoded = morse_table[i].ch;
                    break;
                }
            }
        }
        if (!pe_over && decoded == '*' && pe_len == PROSIGN_SK_LEN && pe_bits == PROSIGN_SK_BITS) {
            /* <SK> (...-.-) is decode-only: it has no ASCII character, so it
             * is shown as text and not added to the table the sender uses. */
            show_text("<SK>");
            decoded = '*';                  /* nothing to echo to the host */
        } else {
            show_char(decoded);
        }
        if (echo_paddle && decoded != '*') {
            echo_put(decoded);
        }
        pe_len = 0;
        pe_bits = 0;
        pe_over = false;
        pe_space_pending = true;
    } else if (pe_space_pending && idle >= 6 * dit_unit()) {
        textview_put(' ');
        if (echo_paddle) {
            echo_put(' ');
        }
        pe_space_pending = false;
    }
}

enum { NO_CLOSURE, DIT_CLOSURE_DAH_OFF, DAH_CLOSURE_DIT_OFF, DIT_CLOSURE_DAH_ON, DAH_CLOSURE_DIT_ON };
static uint8_t last_closure = NO_CLOSURE;

/* K3NG check_paddles(): sample both paddles by level; in ultimatic mode also
 * run its closure (last-touch priority) logic on the memories. */
static void check_paddles(bool raw_dit, bool raw_dash) {
    if (raw_dit) dit_latched = true;
    if (raw_dash) dash_latched = true;
    if (sys_config.mode != KEYER_MODE_ULTIMATE) {
        return;
    }
    switch (last_closure) {
        case DIT_CLOSURE_DAH_OFF:
            if (dash_latched) {
                if (dit_latched) { last_closure = DAH_CLOSURE_DIT_ON; dit_latched = false; }
                else             { last_closure = DAH_CLOSURE_DIT_OFF; }
            } else if (!dit_latched) {
                last_closure = NO_CLOSURE;
            }
            break;
        case DIT_CLOSURE_DAH_ON:
            if (dit_latched) {
                if (dash_latched) { dash_latched = false; }
                else              { last_closure = DIT_CLOSURE_DAH_OFF; }
            } else if (dash_latched) {
                /* the dit just ended: only queue the dah if that paddle is still held */
                if (raw_dash) { last_closure = DAH_CLOSURE_DIT_OFF; }
                else          { dash_latched = false; last_closure = NO_CLOSURE; }
            } else {
                last_closure = NO_CLOSURE;
            }
            break;
        case DAH_CLOSURE_DIT_OFF:
            if (dit_latched) {
                if (dash_latched) { last_closure = DIT_CLOSURE_DAH_ON; dash_latched = false; }
                else              { last_closure = DIT_CLOSURE_DAH_OFF; }
            } else if (!dash_latched) {
                last_closure = NO_CLOSURE;
            }
            break;
        case DAH_CLOSURE_DIT_ON:
            if (dash_latched) {
                if (dit_latched) { dit_latched = false; }
                else             { last_closure = DAH_CLOSURE_DIT_OFF; }
            } else if (dit_latched) {
                if (raw_dit) { last_closure = DIT_CLOSURE_DAH_OFF; }
                else         { dit_latched = false; last_closure = NO_CLOSURE; }
            } else {
                last_closure = NO_CLOSURE;
            }
            break;
        default: /* NO_CLOSURE */
            if (dit_latched && !dash_latched) {
                last_closure = DIT_CLOSURE_DAH_OFF;
            } else if (dash_latched && !dit_latched) {
                last_closure = DAH_CLOSURE_DIT_OFF;
            } else if (dit_latched && dash_latched) {
                last_closure = DIT_CLOSURE_DAH_ON;      /* dit first */
                dash_latched = false;
            }
            break;
    }
}

/* What K3NG does while an element or its gap is timed: look at the opposite
 * paddle only. */
static void sample_during_send(bool raw_dit, bool raw_dash) {
    if (sys_config.mode == KEYER_MODE_IAMBIC_A && raw_dit && raw_dash) {
        iambic_flag = true;
    }
    if (being_sent == SENT_DIT) {
        if (raw_dash) dash_latched = true;
    } else if (being_sent == SENT_DAH) {
        if (raw_dit) dit_latched = true;
    } else {
        if (raw_dash) dash_latched = true;
        if (raw_dit) dit_latched = true;
    }
}

/* Iambic A: a squeeze that is gone by the end of the element leaves no memory. */
static void iambic_a_check(bool raw_dit, bool raw_dash) {
    if (sys_config.mode == KEYER_MODE_IAMBIC_A && iambic_flag && !raw_dit && !raw_dash) {
        iambic_flag = false;
        dit_latched = false;
        dash_latched = false;
    }
}

/* Bug mode: the dah is a manual key-down for as long as the paddle is held. */
static void bug_dah_service(bool raw_dash) {
    if (dash_latched) {
        dash_latched = false;
        /* K3NG keys down for a few microseconds on a stale memory (paddle
         * touched during a dit and already released); here that would be a
         * 1 ms pulse on the TX line, so require the paddle to still be held. */
        if (!bug_dah_flag && raw_dash) {
            bug_dah_flag = true;
            key_on();
        }
    } else if (bug_dah_flag) {
        bug_dah_flag = false;
        key_off();
    }
}

/* K3NG service_dit_dah_buffers() as run from its main loop with nothing being
 * sent: the dit memory first, then the dah memory. */
static void idle_service(uint32_t now, bool raw_dit, bool raw_dash) {
    iambic_a_check(raw_dit, raw_dash);
    if (sys_config.mode == KEYER_MODE_BUG) {
        if (dit_latched) {
            start_dit(now);
        } else {
            bug_dah_service(raw_dash);
        }
        return;
    }
    if (dit_latched) {
        start_dit(now);
    } else if (dash_latched) {
        start_dash(now);
    }
}

/* An element, its gap (and autospace) are over. K3NG then, in one service
 * call, sends the remembered dah straight after a dit; otherwise its main loop
 * comes round again, which samples the paddles a second time at this instant
 * before the next element is chosen. */
static void element_finished(uint32_t now, uint8_t after, bool raw_dit, bool raw_dash) {
    check_paddles(raw_dit, raw_dash);
    if (after == SENT_DIT) {
        if (sys_config.mode == KEYER_MODE_BUG) {
            bug_dah_service(raw_dash);
        } else if (dash_latched) {
            start_dash(now);
            return;
        }
    }
    check_paddles(raw_dit, raw_dash);
    idle_service(now, raw_dit, raw_dash);
}

static void keyer_paddles(uint32_t now, bool raw_dit, bool raw_dash) {
    if (sys_config.mode == KEYER_MODE_STRAIGHT) {
        being_sent = SENT_NONE;
        if (raw_dit || raw_dash) {
            key_on();
            current_state = STATE_DIT;
        } else {
            key_off();
            current_state = STATE_IDLE;
            first_element = true;
        }
        return;
    }

    if (sys_config.mode != KEYER_MODE_BUG && bug_dah_flag) {
        bug_dah_flag = false;               /* mode changed while the bug dah was down */
        key_off();
    }

    if (current_state == STATE_IDLE) {
        check_paddles(raw_dit, raw_dash);
        if (!dit_latched && !dash_latched && !bug_dah_flag) {
            first_element = true;
        }
        idle_service(now, raw_dit, raw_dash);
        return;
    }

    sample_during_send(raw_dit, raw_dash);

    if ((current_state == STATE_DIT || current_state == STATE_DASH) && now >= state_timer) {
        key_off();
        iambic_a_check(raw_dit, raw_dash);
        state_timer = now + (being_sent == SENT_DAH ? dah_gap_ms() : dit_gap_ms());
        current_state = STATE_ELEMENT_SPACE;
    }

    if (current_state == STATE_ELEMENT_SPACE && now >= state_timer) {
        iambic_a_check(raw_dit, raw_dash);
        if (sys_config.autospace) {
            check_paddles(raw_dit, raw_dash);
            if (!dit_latched && !dash_latched) {
                state_timer = now + autospace_ms();
                current_state = STATE_AUTOSPACE;
                return;
            }
        }
    } else if (current_state == STATE_AUTOSPACE && now >= state_timer) {
        iambic_a_check(raw_dit, raw_dash);
    } else {
        return;                              /* still timing the element, gap or autospace */
    }

    /* element, gap and autospace are over */
    uint8_t after = being_sent;
    being_sent = SENT_NONE;
    current_state = STATE_IDLE;
    element_finished(now, after, raw_dit, raw_dash);
}

/* Contact debounce: a level is accepted once it has been stable for this long. */
#define PADDLE_DEBOUNCE_MS 2

static bool debounce(Debounce *d, bool in, uint32_t now) {
    if (in != d->cand) {
        d->cand = in;
        d->since = now;
    } else if (in != d->state && (uint32_t)(now - d->since) >= PADDLE_DEBOUNCE_MS) {
        d->state = in;
    }
    return d->state;
}

void keyer_tick(void) {
    sidetone_service();
    uint32_t now = to_ms_since_boot(get_absolute_time());

    bool pin_dit  = debounce(&deb_dit,  !gpio_get(PIN_PADDLE_DIT),  now);
    bool pin_dash = debounce(&deb_dash, !gpio_get(PIN_PADDLE_DASH), now);
    /* After power-up the paddles are ignored until both have been seen released,
     * so contacts already closed at boot (or a line still settling) send nothing. */
    if (!paddles_armed) {
        if (!pin_dit && !pin_dash) {
            paddles_armed = true;
        } else {
            pin_dit = pin_dash = false;
        }
    }
    bool raw_dit  = sys_config.paddle_swap ? pin_dash : pin_dit;
    bool raw_dash = sys_config.paddle_swap ? pin_dit  : pin_dash;
    bool paddle_down = raw_dit || raw_dash;

    tick_now = now;
    tx_pull();

    /* Break-in: touching a paddle cancels whatever the host has queued. */
    if (paddle_down && (tx_state != TX_IDLE || tx_count > 0)) {
        tx_abort();
        breakin_flag = true;
    }

    if (tx_state != TX_IDLE) {
        tx_run(now);
    }
    /* Start the next queued character once the paddle side is completely quiet.
     * (Checked after tx_run so a character follows its gap without losing a tick.) */
    if (tx_state == TX_IDLE && tx_count > 0 && !paddle_down &&
        current_state == STATE_IDLE && !dit_latched && !dash_latched) {
        tx_start_next(now);
    }
    if (tx_state != TX_IDLE) {
        return;
    }

    paddle_echo_service(now, paddle_down);

    keyer_paddles(now, raw_dit, raw_dash);
}
