jsdriskill/K6TTA-keyer/(commit log)

2026-10-14 Sidetone on pin 5 is now a sine wave
    Run the pin's PWM slice as a one-pin DAC: 11-bit steps, ~61 kHz carrier and
    sample rate. The PWM wrap interrupt (RAM-resident, one call per period)
    writes the next duty from a 256-point sine table with linear interpolation
    and a 32-bit phase accumulator; a 4 ms envelope fades the tone in and out
    so there is no key click (the DC part ramps too, so the pin still starts and
    ends at 0 V). SIDE VOL scales the amplitude linearly, 1 = 10 % of the
    maximum swing. The slice stops and the pin is parked low when the fade ends.
    Code moves out of keyer.c into sidetone.c.
    Host-tested with a PWM/IRQ model: pitch, amplitude, volume steps, distortion
    (-68 dB at 700 Hz, th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
2026-11-02 Add three stored CW messages on GPIO 9-11 with on-device editor
    Claude-Session: https://claude.ai/code/session_01RbGfNF3H2sNSSyZKqGxKnx
2026-11-02 Main screen: scrolling decoded text in large type, speed view on encoder turn
    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
2026-11-06 Sidetone on pin 5 back to a 50% duty square wave
    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
2026-11-06 Fix a spurious A at power-up: wait for paddle pull-ups, ignore paddles until released
    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
    [keyer.c]
2026-11-06 Sidetone on pin 5 back to the PWM sine wave (power-up paddle fix kept)
    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
    [keyer.c, sidetone.c, sidetone.h]
2026-11-07 Setup menu: large centred label, inverted large value, page number only
    [display.c]
2026-11-07 Encoder button: debounced single click per press (no repeat while held)
    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
2026-11-09 Add KiCad hardware draft v0.1 (main + front boards)
    Two KiCad projects generated from the config.h pin map:
    - main board 64x56 mm: RP2040-Zero on sockets (USB-C rear), rig jack
    facing rear with 4N35 output and 10nF sleeve-to-ground RF cap,
    paddle jack with 680R pull-ups and 1nF caps, headphone jack with
    thumbwheel and AO3400A speaker driver, 2x8 right-angle socket
    - front board 76x54 mm: OLED socket, EC11 encoder, three 12 mm
    message buttons, 2x8 header mounted on the back
    Parts are placed but not routed. BOMs (incl. JLCPCB format),
    netlists, previews and the generator scripts are included.
    Claude-Session: https://claude.ai/co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
    [k6tta-front-bom.csv, k6tta-front-netlist.csv, k6tta-front.kicad_pcb, k6tta-front.kicad_sch, k6tta-main-bom.csv, k6tta-main-jlcpcb-bom.csv, k6tta-main-netlist.csv, k6tta-main.kicad_pcb]
2026-11-09 README: document the 680 ohm paddle pull-ups
    Claude-Session: https://claude.ai/code/session_012Kwb2RqJFDmvoaH7udsst5
2026-11-13 Route main and front boards
    [k6tta-front.kicad_pcb, k6tta-main.kicad_pcb]
2026-11-14 Fix RV1 wiring per Alps datasheet (VOL_IN to pin 1), reroute
    [k6tta-main.kicad_pcb, k6tta-main.kicad_sch]
2026-11-14 Hardware: document RK10J pinout from the Alps drawing
    - Thumbwheel footprint/symbol: pads 1/3/5 = end/wiper/end, pads 2/4
    dummy; mounting tabs unnumbered (no "no pin MP" warnings); slot
    sized to the drawing (0.75 x 1.3 mm)
    - Generator data, netlist and BOM: VOL_IN on RV1 pad 1
    - README: boards routed; RP2040-Zero pinout and RV1 verified
    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
    [k6tta-main-bom.csv, k6tta-main-netlist.csv]
2026-11-14 Hardware: add hand-assembly BOM (through-hole and off-board parts)
    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
    [hand-assembly-bom.csv]
2026-11-14 Hardware BOM: LCSC part numbers and LCSC/Amazon split for hand-assembled parts
    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
    [hand-assembly-bom.csv]
